quotentiroler/GuitarPedal/Hardware/pedal/pedal.kicad_pcb

## KiCad design Hardware/pedal/pedal.kicad_pcb (2026-10-15)

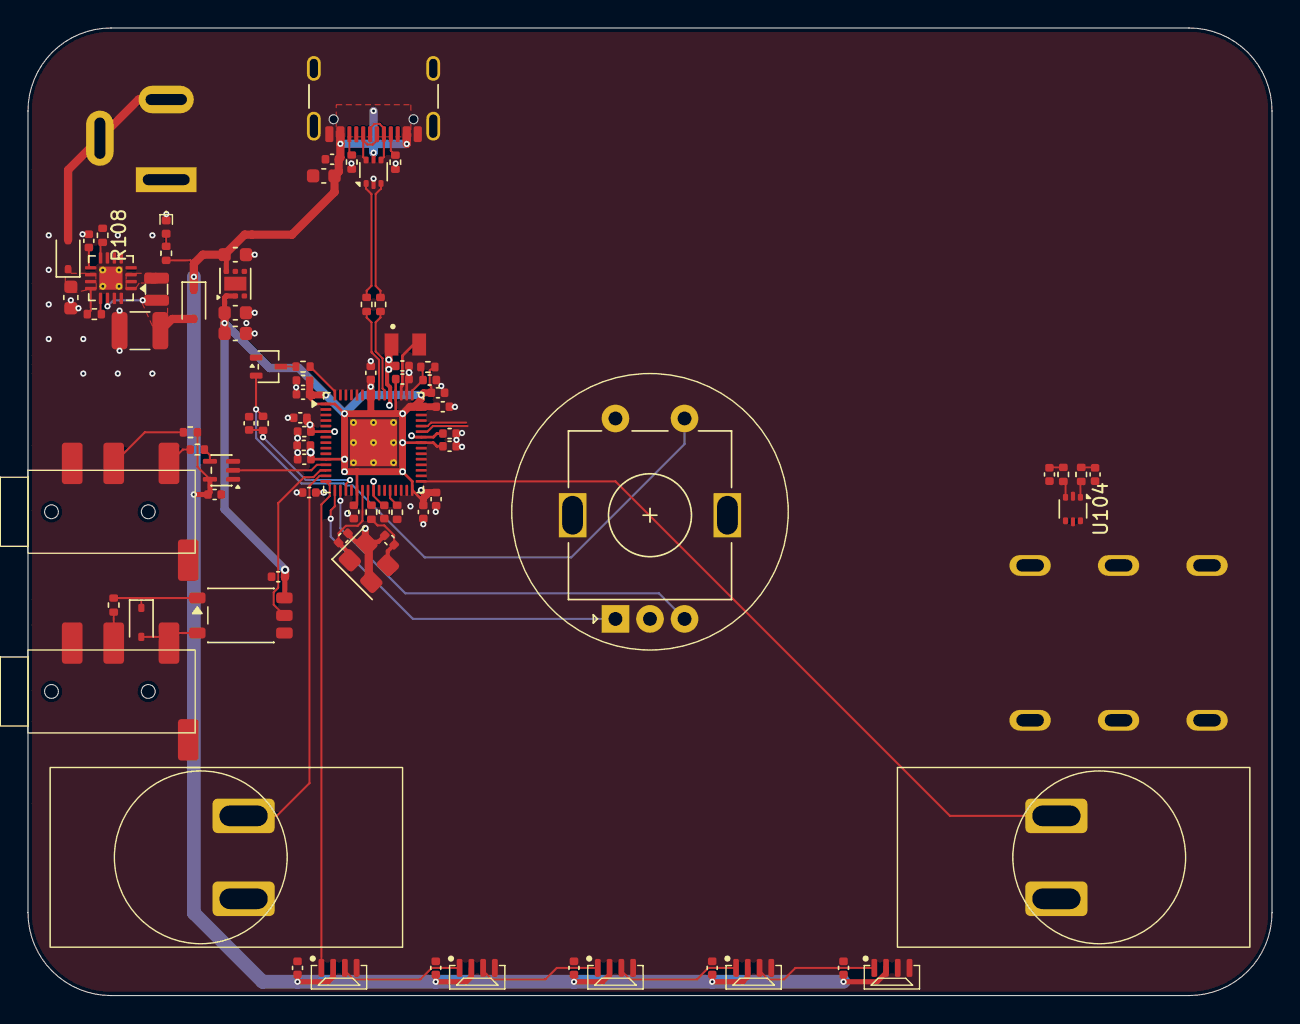
[picture p1: board pedal.kicad_pcb from above]

Board: 4 copper layers, 90.0 x 70.0 mm, 84 parts (0 on the bottom side), 53 nets.

Parts:
C101, C110, C201, C202, C203, C204, C205, C206, C207, C405, C407, C408, C409, C410, C411, C412, C413, C415, C417: 0.1uF; C_0402_1005Metric
C102, C103: 10uF; C_0603_1608Metric
C104: 22uF; C_1210_3225Metric
C105, C108: 22nF; C_0402_1005Metric
C106: 2.2nF; C_0402_1005Metric
C107, C109, C111: 2.2uF; C_0603_1608Metric
C401, C402, C403, C406, C414, C416, C418, C421, C422: 4.7uF; C_0402_1005Metric
C419, C420: 15pF; C_0402_1005Metric
D102: LED; LED_0402_1005Metric
D103, D104, D201: 1N5819WS; D_SOD-323
D106: BAT54SW; SOT-323_SC-70
D202, D203, D204, D205, D206: WS2812B-4020
J101: USB_C_Receptacle_USB2.0_16P; USB_C_Receptacle_GCT_USB4105-xx-A_16P_TopMnt_Horizontal
J102: Barrel_Jack_Switch; Wurth WR-DC 2.1mm Power Jack
J103: AudioJack3_SwitchTR; NRJ6HM-1-PRE
J201, J202: AudioJack4; PJ-320D
L101: 2.2uH; L_0806
L401: 3.3uH; AOTA-B2016
R101, R102: 5k1; R_0402_1005Metric
R103, R104, R106, R107: 1k; R_0402_1005Metric
R105, R108: 100k; R_0402_1005Metric
R201, R202, R203: 220; R_0402_1005Metric
R402, R405, R406: 33Ω; R_0402_1005Metric
R403: 2.2kΩ; R_0402_1005Metric
R404, R407: 1kΩ; R_0402_1005Metric
SW101, SW102: SW_SPST; Daier PBS-24B-2
SW103: RotaryEncoder_Switch_MP; RotaryEncoder_EC11-Switch_Vertical_H20mm
U101, U104: USBLC6-2P6; SOT-666
U102: TPS62153; VQFN-16-1EP_3x3mm_P0.5mm_EP1.68x1.68mm_ThermalVias
U103: TLV76733DRVx; WSON-6-1EP_2x2mm_P0.65mm_EP1x1.6mm
U201: SN74AHCT1G125DCKR; SOT-353_SC-70-5
U202: TLP2310; SO-5-6_4.55x3.7mm_P1.27mm
U402: RP2354A; QFN-60-1EP_7x7mm_P0.4mm_EP3.4x3.4mm_ThermalVias
Y401: ABM8-272-T3; Crystal_SMD_3225-4Pin_3.2x2.5mm

Connections:
+1V1: C402.1, C403.1, C405.1, C407.1, C408.1, L401.1, U402.6 (DVDD), U402.23 (DVDD), U402.39 (DVDD), U402.50 (VREG_FB)
+3V3: C109.1, C111.1, C202.2, C401.1, C409.1, C410.1, C411.1, C412.1, C413.1, C414.1, C415.1, C416.1, C417.1, C418.1, C421.1, C422.1, R402.1, U103.1 (OUT), U103.2 (SNS), U104.5 (VBUS), U202.6 (VDD), U402.1 (IOVDD), U402.11 (IOVDD), U402.20 (IOVDD), U402.30 (IOVDD), U402.38 (IOVDD), U402.44 (ADC_AVDD), U402.45 (IOVDD), U402.49 (VREG_VIN), U402.53 (USB_OTP_VDD), U402.54 (QSPI_IOVDD)
+9V: C103.1, D103.1 (K), R105.1, U102.10 (VIN), U102.11 (VIN), U102.12 (VIN)
/BOOTSEL: D106.3 (COM), R403.1
/DEF: R108.2, U102.8 (DEF)
/EN: R105.2, U102.13 (EN)
/MIDI/MIDI_IN: J201.R1, R201.1
/MIDI/MIDI_OUT: J202.T, R203.2
/RP2354/ADC0: C105.1, R104.1, U402.40 (GPIO26_ADC0)
/RP2354/ADC1: C108.1, R106.1, U402.41 (GPIO27_ADC1)
/RP2354/GPIO8: U201.2, U402.12 (GPIO8)
/RP2354/GPIO9: U202.5 (VO), U402.13 (GPIO9)
/RP2354/GPIO10: SW102.2 (B), U402.14 (GPIO10)
/RP2354/GPIO11: D202.1 (DIN), U402.15 (GPIO11)
/RP2354/GPIO12: SW103.A, U402.16 (GPIO12)
/RP2354/GPIO13: SW103.B, U402.17 (GPIO13)
/RP2354/GPIO14: C110.2, R107.2, U402.18 (GPIO14)
/RP2354/GPIO19: SW101.1 (A), U402.31 (GPIO19)
/RP2354/VREG_AVDD: C406.1, R402.2, U402.46 (VREG_AVDD)
/RP2354/VREG_LX: L401.2, U402.48 (VREG_LX)
/RP2354/XIN: C419.1, U402.21 (XIN), Y401.1
/RP2354/XOUT: R407.1, U402.22 (XOUT)
/SS: C106.2, U102.9 (SS/TR)
/SW: L101.1, U102.1 (SW), U102.2 (SW), U102.3 (SW)
/USB-D+: R405.2, U101.1 (I/O1)
/USB-D-: R406.2, U101.3 (I/O2)
/USBCONN-D+: J101.A6 (D+), J101.B6 (D+), U101.6 (I/O1)
/USBCONN-D-: J101.A7 (D-), J101.B7 (D-), U101.4 (I/O2)
/VOS: C104.1, D104.2 (A), L101.2, U102.14 (VOS)
GND: C101.1, C102.2, C103.2, C104.2, C105.2, C106.1, C107.2, C108.2, C109.2, C110.1, C111.2, C201.1, C202.1, C203.1, C204.1, C205.1, C206.1, C207.1, C401.2, C402.2, C403.2, C405.2, C406.2, C407.2, C408.2, C409.2, C410.2, C411.2, C412.2, C413.2, C414.2, C415.2, C416.2, C417.2, C418.2, C419.2, C420.2, C421.2, C422.2, D102.1 (K), D202.4 (VSS), D203.4 (VSS), D204.4 (VSS), D205.4 (VSS), D206.4 (VSS), J101.A1 (GND), J101.A12 (GND), J101.B1 (GND), J101.B12 (GND), J101.SH (SHIELD), J102.1, J103.RN, J103.S, J103.TN, J202.S, R101.2, R102.2, SW101.2 (B), SW102.1 (A), SW103.C, SW103.MP, SW103.S2, U101.2 (GND), U102.5 (FB), U102.6 (GND), U102.7 (FSW), U102.15 (GND), U102.16 (GND), U102.17 (GND), U103.3 (GND), U103.5 (GND), U103.7 (PAD), U104.2 (GND), U201.1, U201.3 (GND), U202.4 (GND), U402.47 (VREG_PGND), U402.61 (GND), Y401.2 (G), Y401.4 (G)
unnamed: C420.1, R407.2, Y401.3
unnamed: D102.2 (A), R103.1
unnamed: D103.2 (A), J102.2, J102.3
unnamed: D106.2 (K), R107.1, SW103.S1
unnamed: D201.2 (A), J201.T, U202.3 (K)
unnamed: D201.1 (K), R201.2, U202.1 (A)
unnamed: D202.3 (DOUT), D203.1 (DIN)
unnamed: D203.3 (DOUT), D204.1 (DIN)
unnamed: D204.3 (DOUT), D205.1 (DIN)
unnamed: D205.3 (DOUT), D206.1 (DIN)
unnamed: J101.A5 (CC1), R101.1
unnamed: J101.B5 (CC2), R102.1
unnamed: J103.R, U104.6 (I/O1)
unnamed: J103.T, U104.4 (I/O2)
unnamed: J202.R1, R202.2
unnamed: R104.2, U104.3 (I/O2)
unnamed: R106.2, U104.1 (I/O1)
unnamed: R203.1, U201.4
unnamed: R403.2, U402.60 (QSPI_SS)
unnamed: R404.2, U402.26 (RUN)
unnamed: R406.1, U402.51 (USB_DM)
unnamed: R405.1, U402.52 (USB_DP)
VBUS: C101.2, C102.1, C107.1, C201.2, C203.2, C204.2, C205.2, C206.2, C207.2, D104.1 (K), D202.2 (VDD), D203.2 (VDD), D204.2 (VDD), D205.2 (VDD), D206.2 (VDD), J101.A4 (VBUS), J101.A9 (VBUS), J101.B4 (VBUS), J101.B9 (VBUS), R103.2, R108.1, R202.1, U101.5 (VBUS), U103.6 (IN), U201.5 (VCC)
