quotentiroler/GuitarPedal/(commit log)

2026-09-19 Validation: name the component that is wrong, not just the frequency
    The bench can say a build and its netlist disagree. That is the easy
    half: a curve sagging above 2 kHz is a symptom, and what somebody with a
    soldering iron needs is a reference designator.
    faults.py turns the question around. Rather than inverting the
    measurement, every single-component fault that could explain it is
    simulated and the closest one wins. Slow and completely robust: no
    derivative, no assumption that the circuit is linear in its parts, and
    no way to be fooled by a topology it was not told about, because every
    candidate is the topology.
    ngspice.py grows ac_src(), which is ac() on a deck already in hand;
    ac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
2026-09-19 Validation: rank fault candidates by shape, and say what noise it takes
    Two things a simulated measurement never shows, both found by testing
    for them rather than by owning a broken board.
    A measured leg does not arrive at the netlist's absolute level. The
    interface has its own gain and the part under test has its own output
    level, and neither is what is being diagnosed. residual() now removes
    the best constant offset before comparing, so the ranking is about
    shape. Without it a +6 dB offset was enough to make the localiser name
    R4 for a fault in C2 - the right answer did not even place.
    And the candidates do not depend on the measurement, so simulating them
    per diagnosis was wasted wor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
2026-09-19 Validation: diagnose a board by name, not by frequency
    loop.py drives an analog pedal and hands back a calibrated answer.
    compare-spice.py asks the netlist the same question the model is asked.
    Neither says which PART the disagreement lives in, and that is the only
    answer somebody holding a soldering iron can act on.
    So every single-component fault the netlist could have is simulated and
    the closest one wins. The ranking is netfault, a packaged fault
    dictionary - the method is old and the survey is Bandler and Salama,
    Proc. IEEE 73 (1985). What is here is the part specific to this bench:
    the legs, the ladder, and the refusal to answer when nothing fits.
    A signature is one response per dr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
2026-09-19 README: what diagnose.py is, and what it has not done
    It sits under Testing because that is where the instruments are listed,
    and it is flagged as the odd one out because it measures something that
    is not the pedal.
    Three things worth a reader knowing before they try it: netfault is a
    separate install, the method is a fault dictionary and is not new, and
    the ladder is there because a single sweep ranks on noise when the
    circuit is level dependent and does not say so.
    The last paragraph says plainly that no physical board has been through
    it. Every number so far is a fault injected into the netlist and handed
    back, which says the arithmetic works and nothing else.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
2026-09-19 Validation: compare gains, and stop aligning away what a fault moves
    diagnose.py measured absolute level and simulated absolute level, and
    those are not the same quantity: the measured one carries the converter's
    scaling and whatever drive the rung happened to use. align=True hid the
    mismatch by removing a constant offset per rung, and removed the fault
    with it.
    measure_tone() already hands back what was sent beside what came back and
    the sent half was being thrown away, so a measurement is now a gain.
    loop.calibrate() supplies the loop's own response, which its docstring
    puts at 0.24 to 0.59 dB across the band, ten to thirty times the
    resolution a candidate is kept at, so that comes out to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
2026-09-20 Validation: hold the model against the deck, instead of printing it
    compare-spice.py measures the disagreement and prints it. Nothing holds
    it: a change that makes the duty cycle worse reads exactly like one that
    makes it better, and the figures in Effects/rat.h are a comment rather
    than a claim anything checks.
    parity.py records them and compares. Worse is a failure, better is a
    baseline to rewrite with --bless. Six settings, seven metrics each. The
    measurement is compare-spice's own one(), so this adds a ratchet rather
    than a second opinion: it reads 0.943 where compare-spice prints 0.94 at
    Sweep=0.5 and 1.489 against its 1.49 at Filter=0.9.
    alias_delta is only recorded where the reading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
    [bench.c]
2026-09-20 Validation: read float wav, and one signed alignment instead of three
    audio.wav() went through the wave module, which refuses
    WAVE_FORMAT_IEEE_FLOAT outright rather than reading it, so the
    recordings tonetwist.py fetches could not be opened at all. The header
    is parsed here now, and the data chunk is taken as however much is
    really there rather than what its length field claims - a member
    fetched as far as the seconds wanted and no further carries a header
    describing the whole file, and the samples that did arrive are good
    ones.
    compare-spice.py and feed.py each carried their own alignment.
    compare-spice's comment explains at length why it is not
    audio.delay_samples(): that one searches in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
2026-09-20 Validation: null the model against a real pedal, and hold the result
    [RAT] has never been compared to a pedal. compare-spice.py holds it
    against rat-helios.cir and parity.py holds that comparison still, but
    the netlist is ours too, so the pair can agree perfectly and both be
    wrong about the circuit. This measures the model against a recording
    of a Harley Benton Rodent - see tonetwist.py - and ratchets the answer
    the same way parity.py does, reusing its load/save/check rather than
    growing a second copy.
    Two scalars are not in the recording and cannot be recovered from it.
    The output level is fitted and forgotten. The input level decides how
    hard the clamp is driven, which is most of what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
2026-09-20 Validation: make the new scripts executable
    The Makefile runs them as ./parity.py and ./compare-real.py, which is
    how everything else in this directory is invoked, and all four went in
    at 644. It works from a checkout where the mode happens to be right
    and fails from a fresh clone, which is the case that matters.
2026-09-20 Validation: read one member out of a remote archive in one request
    tonetwist.py carried its own range-request plumbing, and pOD-set needs
    the same thing, so it moves to remotezip.py and both use it.
    The member now comes down in a single GET. Letting zipfile drive the
    reads issues one request per megabyte, and against Zenodo that stalls
    partway through a 1.6 GB archive - the central directory already says
    where the member starts and how long it is compressed, so there is
    nothing to learn by asking repeatedly. Twenty seconds of audio went
    from minutes and a hung socket to about three seconds.
    The index is cached beside the audio, and the cache is consulted before
    anything is fetched, so a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
2026-09-20 Validation: read 24-bit wav
    pOD-set is 24-bit PCM, which numpy has no dtype for, so the three bytes
    are assembled by hand with the top one sign-extended. Everything else
    here is 16- or 32-bit and it was refused outright.
    fit_delay() takes its forward transform once instead of once per trial
    delay. The search evaluates about 140 of them and each was paying for
    a transform of the whole passage to throw it away again; on 19 seconds
    that is half the cost of every null in this directory.
2026-09-20 Validation: measure what two real pedals cost each other
    compare-real.py says the model sits 8.8 dB below a real Rodent and
    cannot say whether that is close. Nothing could, because nothing here
    knew what the hardware itself costs. pOD-set does: 27 overdrive pedals,
    each fed the same file by the same motorised robot, so any two of them
    null against each other through exactly the same arithmetic.
    Matched knob positions are not matched drive, and assuming they were is
    the first thing this got wrong. At gain position 2 the Blues Driver
    reads -29 dB against clean, which is a filter with an opinion; at
    position 5 it reads -9 and is clipping hard. Comparing those would
    measure the knob. So ea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
2026-09-20 Validation: let the deck step finer than the sample rate
    tran() pinned ngspice's maximum internal step to 1/fs, which is three
    steps per cycle at 16 kHz and not a waveform. Comparing the model
    against it up there reported the model 12.15 dB down. Letting ngspice
    step 4x finer says 2.55 and 16x says 2.65, so the 12 dB was the
    reference inventing content and had nothing to do with the model. It
    was reported confidently and there was no way to tell from the outside.
    'over' is internal steps per sample and defaults to 1, so nothing that
    exists changes: parity.py reads the same six settings unchanged with it
    in place. Anything looking above about 8 kHz has to raise it and pay
    the runtime for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
2026-09-20 Audio: say what happens above Nyquist, and hold [RAT]'s Filter at 0
    The header said "Nothing asks". [RAT] asks, at every Filter setting of
    0: the corner is 1/(2 pi 1k5 3n3) = 32.2 kHz against a 24 kHz Nyquist,
    fastsincos() wraps, and the filter lands at 15.8 kHz instead. The
    pedal's brightest tone setting is two decibels darker than the circuit
    it is named after.
    Returning alpha 1 there is the defensible answer - a pole that far out
    is a pass, and against the analog pole it is 0.96 dB worst where the
    wrap is 2.07. It was written, built and measured, and it is 3 dB
    worse: small_signal_worst at Filter=0 goes 1.305 -> 4.340 and
    alias_delta -7.992 -> -4.940. The wrap is cancelling the chain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
2026-09-20 Validation: stop lag_samples answering outside the window it was given
    Asked for a peak within +-8 samples it returned -4624 and +67021.
    The parabola through the correlation peak assumes the peak is one.
    Where the true one is outside max_lag, argmax lands on an edge of the
    searched window instead, which is not a maximum, and the denominator
    a-2b+c goes through nothing. The guard was 'if den else 0.0', which
    only catches exactly zero.
    So it interpolates only where the curvature says there is a peak, and a
    sub-sample correction is held to half a step whatever the arithmetic
    produces. It is the one thing this function promises.
    Found by nulling tone bursts, where a clipped 220 Hz waveform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
2026-09-20 Validation: score the model against a capture of the pedal
    capture-rat.py takes the Helios and analyse-rat-bench.py fits the clamp
    from it - that is where RAT_D_N, RAT_D_IS and RAT_D_RS came from.
    Nothing scored the answer. The constants were fitted to a transfer
    curve, and whether they are the ones that make the waveforms agree is a
    different question and the one somebody asked.
    So the captured waveforms get nulled against the model and held the way
    compare-spice.py's numbers are. Both sides of the loop are in one
    frame, so there is no input level to search for the way there is
    against a recording somebody else made; only the output gain is fitted
    and it is printed. --knobs says what th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
2026-10-15 Start re-doing the 'pedal' part without any actual audio processing
    The 'minimal' board is what I think is the right way to go, and works
    very well. Being able to use WebMIDI over BLE just means that it's a
    lot more convenient to use from a phone or a computer.
    But as an actual *pedal* that minimal board isn't great. It
    intentionally has no actual physical controls, and since it's USB-C only
    it doesn't work well on a traditional pedal board anyway.
    But the plan was always to make things a bit more modular. This is the
    beginnings of that. The non-minimal 'pedal' design has stomp switches
    and hardware MIDI connectors and an expression pedal jack, and those all
    worked fine. It also has t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
